0815Sailsman/semfach-door/README.md

# semfach-door
Toller Code für die Facharbeit ^^
