0815Sailsman/semfach-door/Ausarbeitung/SemfTextneu.odt

Seminarfach-Arbeit

Durchführungsphase:

Was haben wir wie umgesetzt ?

Allgemein ist in der Automat in verschiedene Mikrocontroller aufgeteilt, so hat man einmal einen ESp32, welcher als „Master“ gilt und zusätzlich noch zwei Arduino-Nanos, welche als deren „Slaves“ agieren. Der Esp32 ist dabei für die ganze Zusammenarbeit zwischen den Systemen zuständig, während die Arduinos zum Auslesen von Daten und dem Durchführen von Aktionen benötigt werden.

Das Eintragen der Personen läuft über einen auf dem Esp32 gehosteten Webserver, über den man sich per vom Esp32 ausgehenden WLAN (Esp32-Acces-Point) verbinden kann. Auf der dann aufrufbaren Website kann man anschließend seine Daten angeben, welche anschließend in einer eigens dafür entworfenen Datenbank mit einem für jede Person einzigartig generierten Code gespeichert werden. Dieser Code wird nach der Registrierung der Person auf der Website angezeigt. Die Datenbank wird auf einer SD-Karte angelegt, welche über ein Modul mit dem Esp32 über SPI verbunden ist, so dass dieser direkt die SD-Karte beschreiben und auslesen kann. Zusätzlich wird in dieser Datenbank per Unixzeit vermerkt, wann die Person zuletzt und für wie Lange im Restaurant war und ob Sie sich gerade im Gebäude befindet.

Um als Kunde nun ins Restaurant zu gelangen, muss man seinen Code eingeben. Dies erfolgt über ein Tastenfeld und ein LCD-Display.

Das Tastenfeld ist dabei an einem Arduino-Nano angeschlossen, welcher die eingegeben Zahlen erkennt und in einem Array speichert. Dieses Array wird alle 0.5 Sekunden von dem Esp32 abgefragt und dann vom Arduino an diesen übermittelt. Mit dem Druck der „*-Taste“ lässt sich das letzte Zeichen löschen und mit dem Benutzen der „#-Taste“ werden die Daten für den Esp32 zum Verarbeiten freigegeben. Die Freigabe erfolgt dabei über ein Anhängsel im Array, so bedeutet der Anhang „n“, dass das Array noch nicht bereit ist und der Anhang „y“, dass die Daten so überprüft werden sollen (der Kunde also die „#-Taste“ gedrückt hat). Die Anzeige auf dem LCD-Display erfolgt allerdings über den Esp32, da der Arduino nur als Slave fungiert und daher nur abgefragte Daten übermitteln kann.

Zusammengefasst fragt der Esp32 die Daten des Arduinos ab und überträgt diese dann auf die Displays (Alles per I2C).

Wurde nun die „#-Taste“ gedrückt und die Daten wurden zur Verarbeitung freigegeben, wird über die implementierte Turing-Maschine überprüft, ob der Code so überhaupt stimmen kann (nähere Erläuterung später). Kann der Code stimmen, wird auf der Datenbank geguckt zu welcher Person der Code gehört, anschließend wird überprüft, ob sich die Person momentan schon im Restaurant befindet oder nicht. Ist die Person nicht im Restaurant, wird der Zeitpunkt des Eintritts per Unixzeit gespeichert und ein Signal wird vom Esp32 an den Arduino geschickt, damit dieser die Schranke öffnet. Die Schranke ist dabei per Servomotor an den Arduino angeschlossen. Bekommt der Arduino das Signal vom Esp32, öffnet er die Schranke und wertet die Daten eines angeschlossenen Abstandssensor aus. Der Abstandssensor sitzt dabei direkt unter der Schranke. Fällt der gemessene Wert des Abstandssensor unter 30cm, bedeutet dies, dass die Person die Schranke passiert hat, wodurch die Schranke 2 Sekunden später schließt. Möchte man nun wieder aus dem Restaurant hinaus, ist der Vorgang ähnlich, nur das nun in der Datenbank überprüft wird, ob die Person schon draußen ist, oder nicht.
