0815Sailsman/semfach-door/Ausarbeitung/ergebnis.odt

Ergebnis

Vorstellung der Ergebnisse

Schlussendlich ist eigentlich alles funktional ziemlich gut zusammengekommen. Der Registrierungsprozess funktioniert ziemlich gut und auch die Anmeldung sowie die Abmeldung funktionieren. Wir hatten bis zum Ende immer noch ein paar Probleme mit den Schranken, dass sie sich manchmal nicht ganz geöffnet haben aber an sich hat das auch immer funktioniert. Insgesamt ist das System jetzt dazu in der Lage Registrierungen entgegenzunehmen, Anmeldungen/Abmeldungen durchzuführen und Leute rein- rauszulassen wenn ein erfolgreicher An- Abmeldeprozess erkannt wird.
