0815Sailsman/semfach-door/Ausarbeitung/links_teile.odt

Arduino Starter Kit:

https://www.amazon.com/ELEGOO-Complete-Starter-Tutorial-Arduino/dp/B08J3V5WPX

ESP32:

https://www.amazon.de/-/en/AZDelivery-NodeMCU-Development-Successor-Module/dp/B07Z83MF5W/

SD-Card Reader

https://create.arduino.cc/projecthub/electropeak/sd-card-module-with-arduino-how-to-read-write-data-37f390

Arduino Nano:

https://www.amazon.de/-/en/Elegoo-Compatible-Nano-Board-Arduino/dp/B0725CFKWK/

LCD I²C Backpack:

https://www.amazon.com/-/de/dp/B07D3YPK3H/
