0815Sailsman/semfach-door/Ausarbeitung/gliederung.odt

Gliederung:

-1. Deckblatt

0. Einleitung

0.1 Begründung / Motivation

0.2 Warum beschäftigen wir uns mit dem Thema?

0.3 Zielsetzung

Inhaltsverzeichnis

1. Planungsphase

1.1 Dokumentation der Planungsphase

1.2 Was habt ihr euch überlegt, wie man die Zielsetzung erreichen kann / die Probleme lösen kann?

1.3 Welche Materialien / Bauteile oder auch softwareseitige Funktionen werden benötigt? Warum gerade diese?

1.4 Wie / wo habt ihr Euch das besorgt?

2. Durchführungsphase

2.1 Beschreibung der Durchführungsphase

2.2 Was habt ihr wie umgesetzt?

2.3 Bilder ???

2.4 PROBLEME UND IHRE LÖSUNGEN

2.5 Evtl. Änderungen der Planungen??

3. Ergebnis

3.1 Dokumentation / Vorstellung der Ergebnisse

3.2 Bilder vom Exponat

3.3 Was geht / Was geht nicht? (RFID DO THE NO WORKING AND TIME NO THERE)

3.4 Warum geht was nicht? → Analyse

3.5 Verbesserungsideen?

4. Fazit / Schluss

4.1 Abschließende Gedanken

4.2 Was hat geklappt / was nicht?

4.3 Was gelernt / was fehlt?

4.4 Verbesserungen / Erweiterungen

4.5 Spassfaktor?

4.6 Wichtig → Ein Bezug zur Einleitung macht die Sache rund ;-)

5. Quellen

5.1 Literaturverzeichnis

5.2 Abbildungsverzeichnis

5.3 Anhang
