0815Sailsman/semfach-door/Ausarbeitung/Schülererklärung_Nelly.pdf

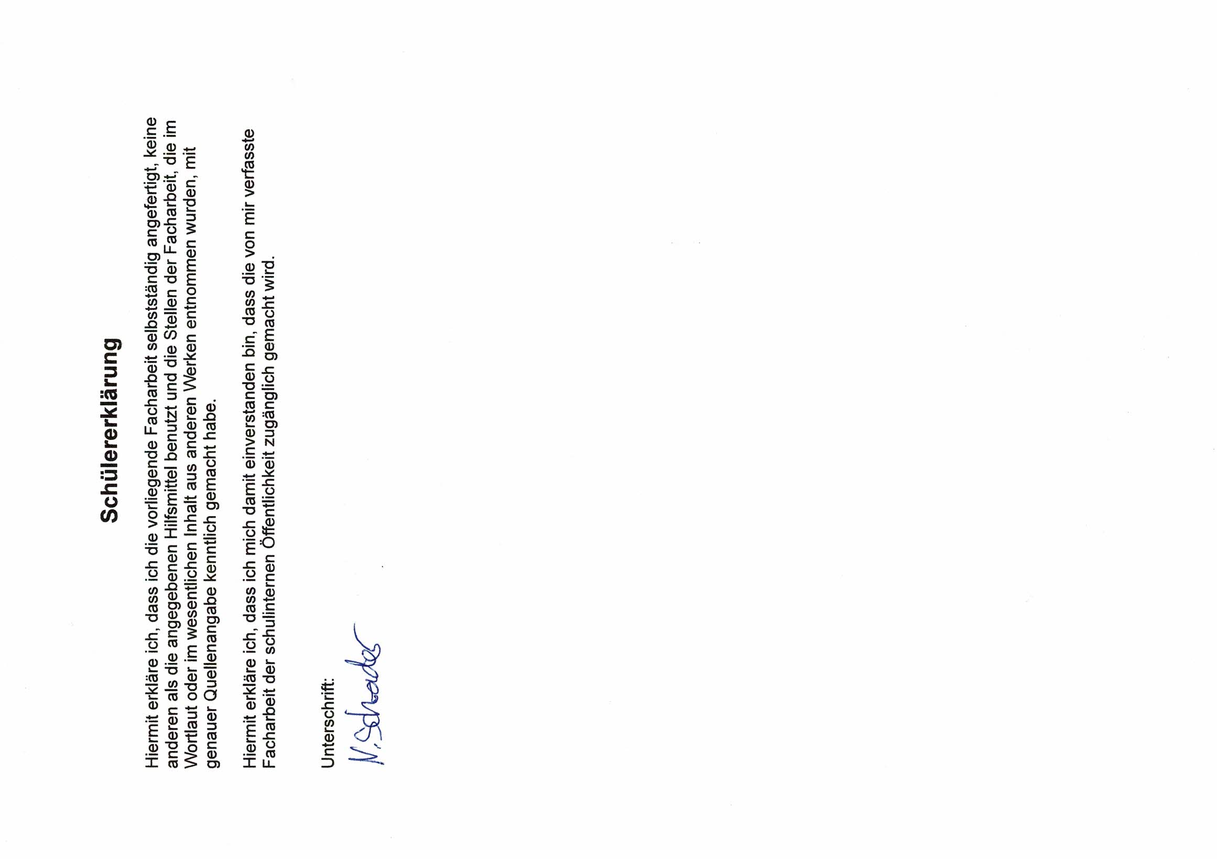
[picture p29: page 1]
