0815Sailsman/semfach-door/Ausarbeitung/Eklaerung Daniel.pdf

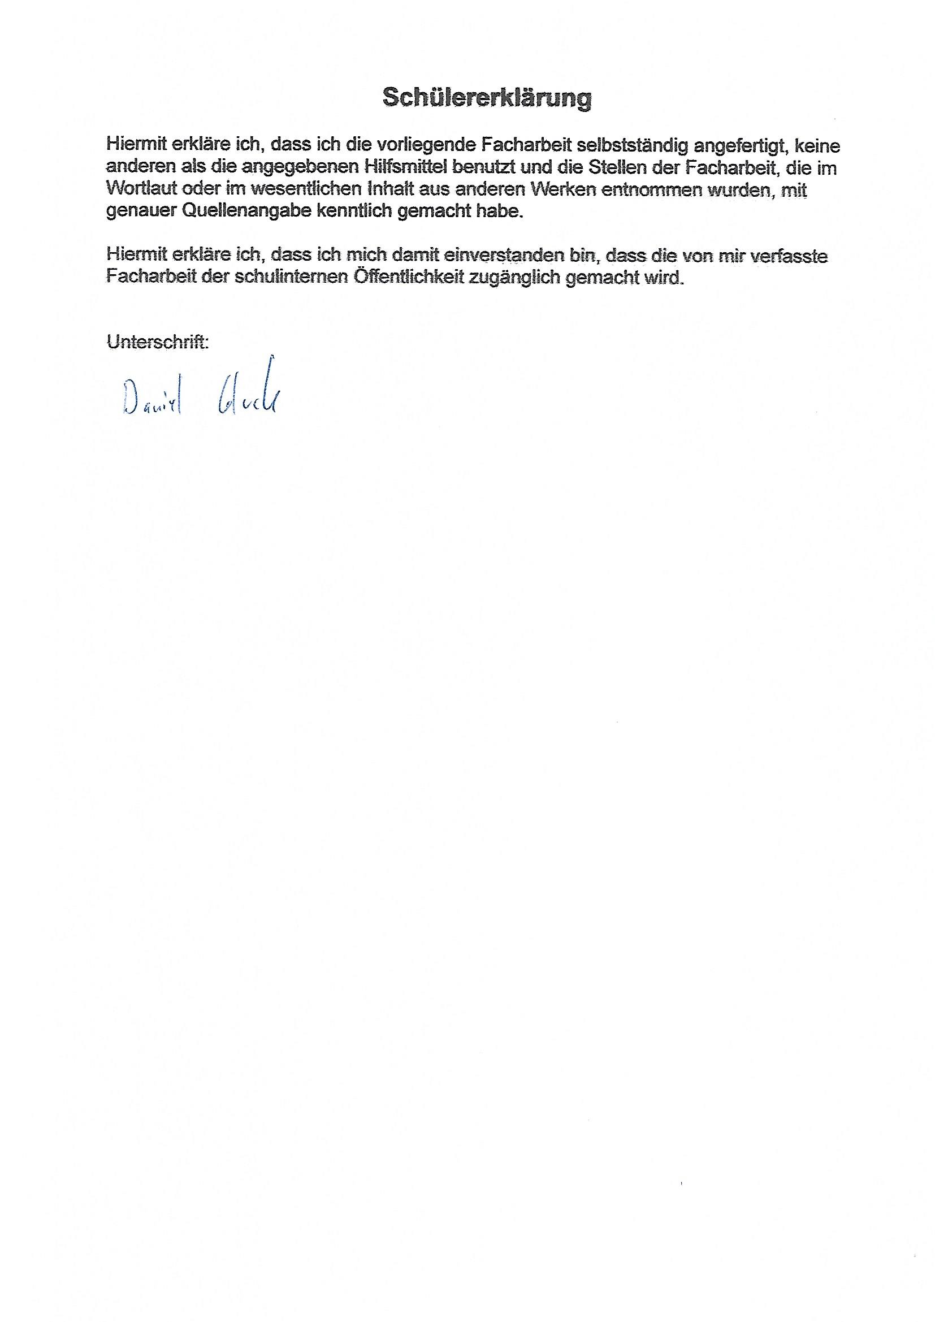
[picture p30: page 1]
