0815Sailsman/semfach-door/actual_automat.html1.gif

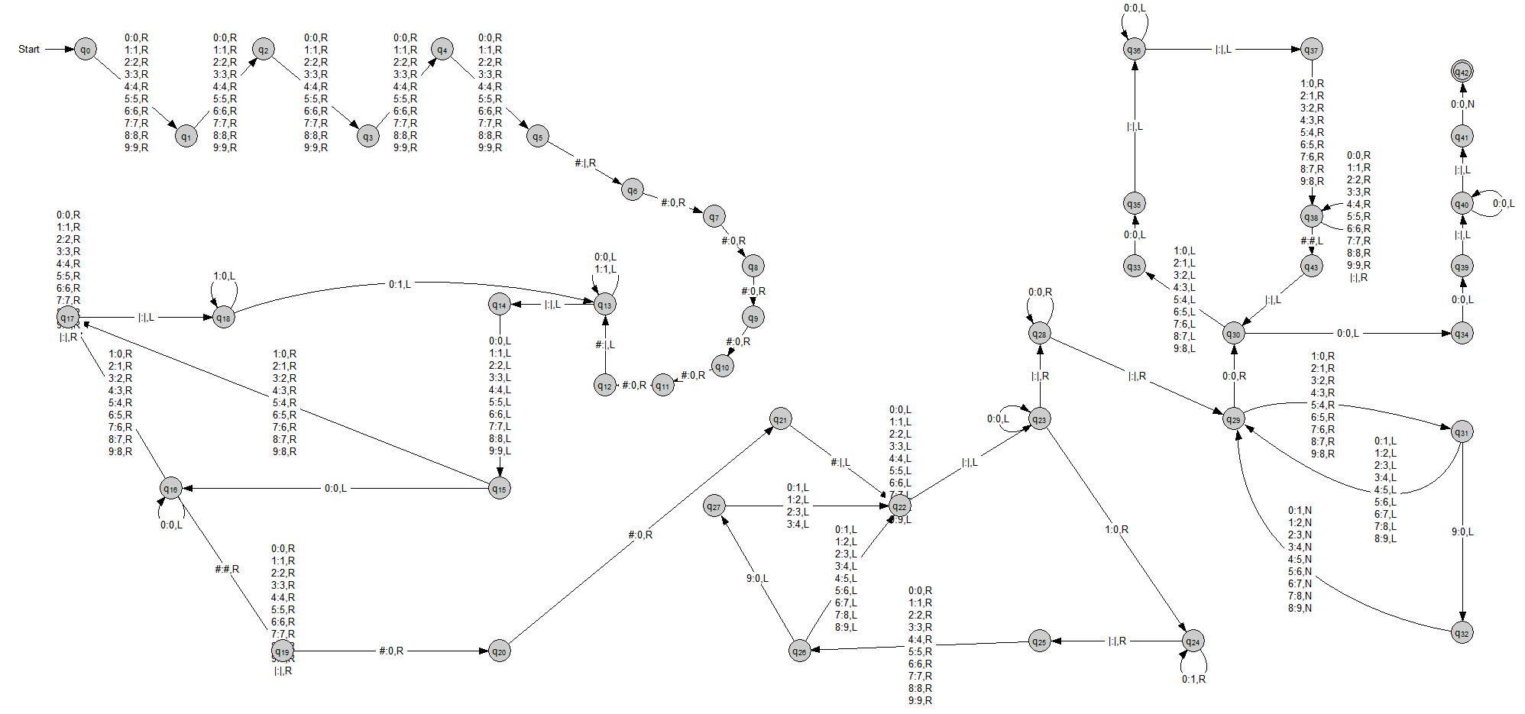
actual_automat.html1.gif
