0815Sailsman/semfach-door/actual_automat.html3.gif

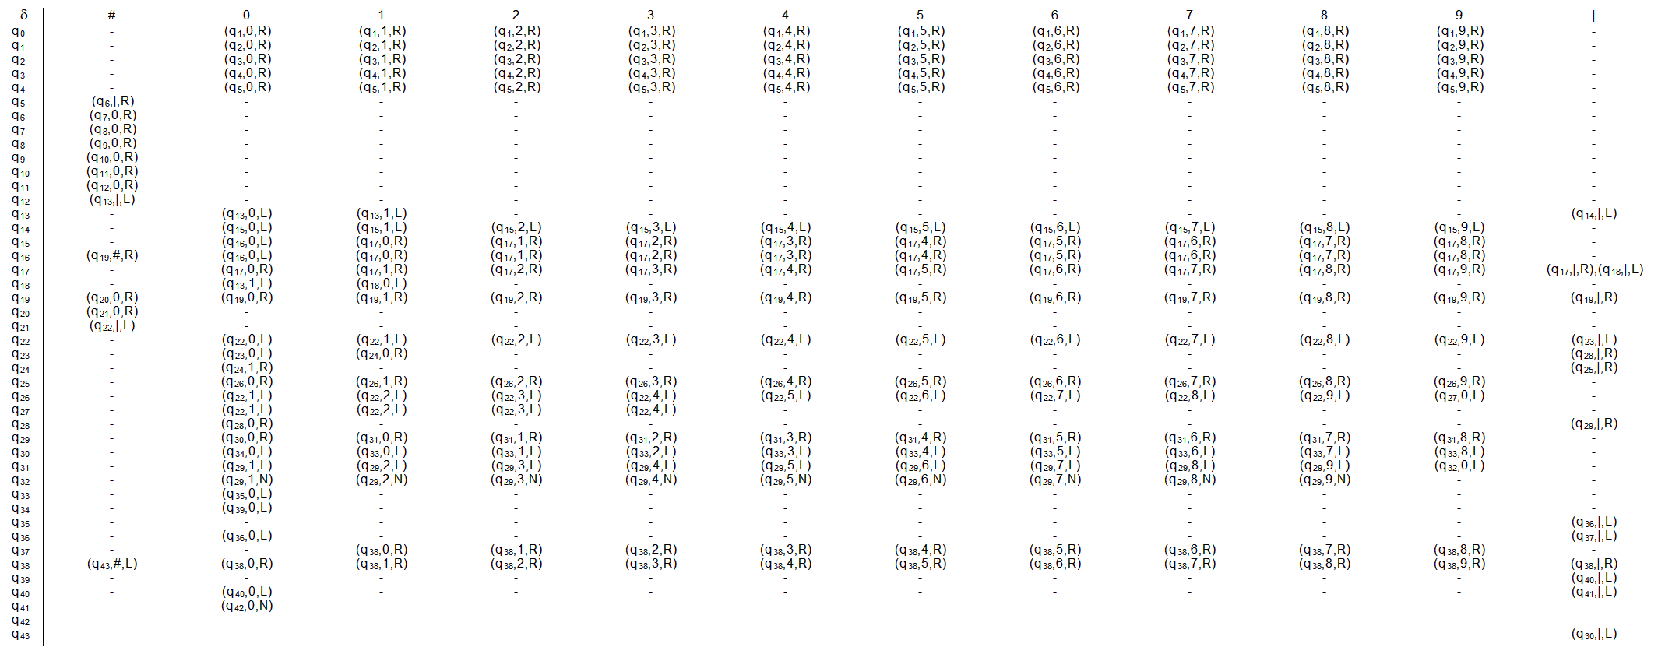
actual_automat.html3.gif
