0815Sailsman/semfach-door/shopping.txt

 X 2x Arduino
 X 2x Servo
 X 1x ESP 32
 X 2x Numberfield
 Y Baumaterial
 => Done ^^
