0815Sailsman/semfach-door/(list of files, drawings)

Other design files:
Ausarbeitung/schaltplan.fzz
