0815Sailsman/semfach-door/accesspoint/accesspoint.ino

#include <Arduino.h>
#ifdef ESP32
  #include <WiFi.h>
  #include <AsyncTCP.h>
#else
  #include <ESP8266WiFi.h>
  #include <ESPAsyncTCP.h>
#endif
#include <ESPAsyncWebServer.h>

// Replace with your network credentials
const char* ssid     = "ESP32-Access-Point";
const char* password = "123456789";

// Set web server port number to 80
AsyncWebServer server(80);

// Variable to store the HTTP request
String header;

const char* PARAM_INPUT_1 = "name";
const char* PARAM_INPUT_2 = "address";
const char* PARAM_INPUT_3 = "email";

// HTML web page to handle 3 input fields (input1, input2, input3)
const char index_html[] PROGMEM = R"rawliteral(
<!DOCTYPE HTML><html><head>
  <title>ESP Input Form</title>
  <meta name="viewport" content="width=device-width, initial-scale=1">
  </head><body>
  <form action="/get">
    Name: <input type="text" name="name"><br>
    Address: <input type="text" name="address"><br>
    EMail: <input type="text" name="email"><br>
    <input type="submit" value="Submit">
  </form><br>
</body></html>)rawliteral";

void notFound(AsyncWebServerRequest *request) {
  request->send(404, "text/plain", "Not found");
}


void setup() {
  Serial.begin(115200);

  // Connect to Wi-Fi network with SSID and password
  Serial.print("Setting AP (Access Point)…");
  // Remove the password parameter, if you want the AP (Access Point) to be open
  WiFi.softAP(ssid, password);

  IPAddress IP = WiFi.softAPIP();
  Serial.print("AP IP address: ");
  Serial.println(IP);

    // Send web page with input fields to client
  server.on("/", HTTP_GET, [](AsyncWebServerRequest *request){
    request->send_P(200, "text/html", index_html);
  });


  // Send a GET request to <ESP_IP>/get?input1=<inputMessage>
  server.on("/get", HTTP_GET, [] (AsyncWebServerRequest *request) {
    String inputName;
    String inputAddress;
    String inputEmail;
    String inputParam;
    // GET input1 value on <ESP_IP>/get?input1=<inputMessage>
    if (request->hasParam(PARAM_INPUT_1) && request->hasParam(PARAM_INPUT_2) && request->hasParam(PARAM_INPUT_3)) {
      inputName = request->getParam(PARAM_INPUT_1)->value();
      inputAddress = request->getParam(PARAM_INPUT_2)->value();
      inputEmail = request->getParam(PARAM_INPUT_3)->value();
      inputParam = PARAM_INPUT_1;
    }
    else {
      inputName = "No message sent";
      inputParam = "none";
    }
    Serial.println(inputName);
    Serial.println(inputAddress);
    Serial.println(inputEmail);
    request->send(200, "text/html", "HTTP GET request sent to your ESP on input field (" 
                                     + inputParam + ") with value: " + inputName + ", " + inputAddress + ", " + inputEmail + 
                                     "<br><a href=\"/\">Return to Home Page</a>");
  });
  server.onNotFound(notFound);
  
  server.begin();
}

void loop(){
}
