0815Sailsman/semfach-door/main.py

from band import Band
from consts import *


class TM:
    def __init__(self):
        self.state = 0
        self.band = Band()
        self.band.set_standard_char("#")
        self.band.fill_with_std()

    def execute(self, input):
        self.band.set_position(1)
        self.band.write_at_start(input)
        final_states = [42]
        while self.state is not None:
            #print("State+" + str(self.state))
            read_value = self.band.read()
            #print("read_value:" + str(read_value))
            write_value = self.get_write_value(self.state, read_value)
            #print("write:" + str(write_value))
            if not write_value:
                return False
            next_state = self.get_next_state(self.state, read_value)
            if next_state in final_states:
                return True
            if not next_state:
                return False
            next_move = self.get_next_move(self.state, read_value)
            #print("move" + next_move)
            self.band.write(write_value)
            self.state = next_state
            self.band.move(next_move)

    def get_write_value(self, state, read):
        if state == 0:
            if read == "0":
                return "0"
            elif read == "1":
                return "1"
            elif read == "2":
                return "2"
            elif read == "3":
                return "3"
            elif read == "4":
                return "4"
            elif read == "5":
                return "5"
            elif read == "6":
                return "6"
            elif read == "7":
                return "7"
            elif read == "8":
                return "8"
            elif read == "9":
                return "9"
        elif state == 1:
            if read == "0":
                return "0"
            elif read == "1":
                return "1"
            elif read == "2":
                return "2"
            elif read == "3":
                return "3"
            elif read == "4":
                return "4"
            elif read == "5":
                return "5"
            elif read == "6":
                return "6"
            elif read == "7":
                return "7"
            elif read == "8":
                return "8"
            elif read == "9":
                return "9"
        elif state == 2:
            if read == "0":
                return "0"
            elif read == "1":
                return "1"
            elif read == "2":
                return "2"
            elif read == "3":
                return "3"
            elif read == "4":
                return "4"
            elif read == "5":
                return "5"
            elif read == "6":
                return "6"
            elif read == "7":
                return "7"
            elif read == "8":
                return "8"
            elif read == "9":
                return "9"
        elif state == 3:
            if read == "0":
                return "0"
            elif read == "1":
                return "1"
            elif read == "2":
                return "2"
            elif read == "3":
                return "3"
            elif read == "4":
                return "4"
            elif read == "5":
                return "5"
            elif read == "6":
                return "6"
            elif read == "7":
                return "7"
            elif read == "8":
                return "8"
            elif read == "9":
                return "9"
        elif state == 4:
            if read == "0":
                return "0"
            elif read == "1":
                return "1"
            elif read == "2":
                return "2"
            elif read == "3":
                return "3"
            elif read == "4":
                return "4"
            elif read == "5":
                return "5"
            elif read == "6":
                return "6"
            elif read == "7":
                return "7"
            elif read == "8":
                return "8"
            elif read == "9":
                return "9"
        elif state == 5:
            if read == "#":
                return "|"
        elif state == 6:
            if read == "#":
                return "0"
        elif state ==7:
            if read == "#":
                return "0"
        elif state == 8:
            if read == "#":
                return "0"
        elif state == 9:
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
                return "R"
            elif read == "1":
                return "R"
        return False


automat = TM()
result = automat.execute(["8", "8", "8", "8", "5"])
if result:
    print("Der Code funktioniert!")
else:
    print("Der Code funktioniert nicht!")
