0815Sailsman/semfach-door/(commit log)

2021-02-23 Create 4x4zuLCD-ArduinoCode
2021-02-26 esp32 complete
2021-03-03 updated esp32complete and lcd
2021-03-15 schaltung und problemebegin
    [schaltplan.fzz]
2021-03-17 code ienfügen und so weuter und so fort...
2021-03-19 aufgewräumter code und erklaerung daniel
